microsysdeve/fjl_20191023/清单.pdf

品名 | 型号 | 数量 | 组件 | 备注
三相电压继电器 | XJ3-G | 1 | 总控制
空气开关 | NM1-3300-400A 三相 | 1 | 总控制
启动按钮绿 | 2常开2常闭红, | 1 总控制
停止按钮绿 | 2常开2常闭绿 | 1 | 总控制
启动按钮绿 | 2常开2常闭红, | 400A接触器控制
停止按钮绿 | 2常开2常闭绿 | | | 400A接触器控制
急停按钮（蘑菇头）4常开4常闭，带自锁 | | 2 | 总控制
三相电压表 | 42L6 500V | 1 | 总控制
三相电流表 | 42L6 400A | 1 | 总控制
互感器 | Bh-0.66 400/5 | 1 | 总控制
A相指示灯 | ND16-220V 红 | 1 | 总控制
C相指示灯 | ND16-220V 黄 | 1 | 总控制
B相指示灯 | ND16-220V 绿 | 1 | 总控制
接触器 | CJ20-400A 380V | 1 | 总控制
220-24V电源 150W | | 1
接触器 | CJX2-220V 0910 | 1 | 热风循环燃烧机控制
接触器 | CJX2-220V 3210 | 1 | 热风循环风机控制
空气开关 | DZ47-32A-3P D型 | 1 | 热风循环
空气开关 | DZ47-5A-3P | 1 | 热风循环
热继电器 | NR2-36/Z 23-32A | 1 | 热风循环
接线端子 | TD-20A/3P | 1 | 热风循环
接线端子 | TD-15A/7P | 1 | 热风循环
接触器 | CJX2-220V 0910 | 1 | 烘道热能水循环
空气开关 | DZ47-5A-2P | 1 | 烘道热能水循环
热继电器 | NR2-25/Z 5.5-8A | 1 | 烘道热能水循环
接线端子 | TD-15A/5P | 1 | 烘道热能水循环
接触器 | CJX2-220V 0910 | 1 | 热水炉
接触器 | CJX2-220V 1810 | 1 | 热水炉
空气开关 | DZ47-25A-3P D型 | 1 | 热水炉
空气开关 | DZ47-5A-2P | 1 | 热水炉
继电器 | JZX-24VF(D)/4Z-24V | 6 | 热水炉
热继电器 | NR2-25/Z 12-18A | 1 | 热水炉
接线端子 | TD-15A/22P | 1 | 热水炉
接触器 | CJX2-220V 1810 | 5 | 前处理
接触器 | CJX2-220V 2510 | 3 | 前处理
空气开关 | DZ47-10A-3P D型 | 5 | 前处理
空气开关 | DZ47-25A-3P D型 | 3 | 前处理
热继电器 | NR2-25/Z 9-13A | 5 | 前处理
热继电器 | NR2-25/Z 12-18A | 3 | 前处理
接线端子 | TD-20A 30P | 1
空气开关 | DZ47-16A-2P | 2 | 备用
空气开关 | DZ47-16A-3P | 2 | 备用
空气开关 | DZ47-40A-3P | 2 | 备用
空气开关 | DZ47-63A 3P | 2 | 备用
接线端子 | TD-10A/16P | 1 | | 2个单相16A空开+2个三相16A空开
接线端子 | TD-60A/12P | 1 | | 2个三相40A空开+2个三相60A空开
接线端子 | TD-15A/10P | 1
