microsysdeve/fjl_20191023/fjl_20191023供应清单.xlsx

Sheet: Sheet1
品名 | 型号 | 数量 | 组件 | 备注
三相电压继电器 | XJ3-G | 1 | 总控制
空气开关 | NM1-3300-400A 三相 | 1 | 总控制
启动按钮绿 | 2常开2常闭红, | 1 | 总控制
停止按钮绿 | 2常开2常闭绿 | 1 | 总控制
启动按钮绿 | 2常开2常闭红, | 1 | 总控制 | 400A接触器控制
停止按钮绿 | 2常开2常闭绿 | 1 | 总控制 | 400A接触器控制
急停按钮（蘑菇头） | 4常开4常闭，带自锁 | 2 | 总控制
互感器 | Bh-0.66 400/5 | 1 | 总控制
A相指示灯 | ND16-220V 红 | 1 | 总控制
C相指示灯 | ND16-220V 黄 | 1 | 总控制
B相指示灯 | ND16-220V 绿 | 1 | 总控制
接触器 | CJ20-400A 380V | 1 | 总控制
220-24V电源 200W |  | 1
空气开关 | NXB-5A 2P | 1 | 控制回路控制
接触器 | CJX2-220V 0910 | 1 | 热风循环燃烧机控制
接触器 | CJX2-220V 3210 | 1 | 热风循环风机控制
空气开关 | NXB-32A-3P D型 | 1 | 热风循环
空气开关 | NXB-5A-3P | 1 | 热风循环
热继电器 | NR2-36/Z 23-32A | 1 | 热风循环
接线端子 | TD-20A/3P | 1 | 热风循环
接线端子 | TD-15A/7P | 1 | 热风循环
接触器 | CJX2-220V 0910 | 1 | 烘道热能水循环
空气开关 | NXB-5A-2P | 1 | 烘道热能水循环
热继电器 | NR2-25/Z 5.5-8A | 1 | 烘道热能水循环
接线端子 | TD-15A/5P | 1 | 烘道热能水循环
接触器 | CJX2-220V 0910 | 1 | 热水炉
接触器 | CJX2-220V 1810 | 1 | 热水炉
空气开关 | NXB-25A-3P D型 | 1 | 热水炉
空气开关 | NXB-5A-2P | 1 | 热水炉
继电器 | JZX-24VF(D)/4Z-24V | 6 | 热水炉
热继电器 | NR2-25/Z 12-18A | 1 | 热水炉
接线端子 | TD-15A/22P | 1 | 热水炉
接触器 | CJX2-220V 1810 | 5 | 前处理
接触器 | CJX2-220V 2510 | 3 | 前处理
空气开关 | NXB-10A-3P D型 | 5 | 前处理
空气开关 | NXB-25A-3P D型 | 3 | 前处理
热继电器 | NR2-25/Z 9-13A | 5 | 前处理
热继电器 | NR2-25/Z 12-18A | 3 | 前处理
接线端子 | TD-20A 30P | 1
空气开关 | NXB-16A-2P | 5 | 备用
空气开关 | NXB-16A-3P | 2 | 备用
空气开关 | NXB-40A-3P | 2 | 备用
空气开关 | NXB-63A 3P | 2 | 备用
接线端子 | TD-10A/16P | 1 |  | 2个单相16A空开+2个三相16A空开
接线端子 | TD-60A/12P | 1 |  | 2个三相40A空开+2个三相60A空开
接线端子 | TD-15A/10P | 1
接触器 | CJX2-220V 0910 | 1 | 粉尘控制 | 喷房电源1
接触器 | CJX2-220V 0910 | 1 | 粉尘控制 | 喷房电源2
继电器 | JZX-24VF(D)/4Z-24V | 6 | 粉尘控制
按钮 |  | 6 | 粉尘控制 | 二常开二常闭
24V指示灯 | 红色 | 1 | 粉尘控制
选择开关 |  | 1 | 粉尘控制 | 二常开二常闭

Sheet: 联动控制器购买清单
编号 | 器件名称 | 规格 | 功能
SB1 | 按钮 | LAY2，不自锁,1常开1常闭 | 启动
SB2 | 按钮 | LAY2，不自锁,1常开1常闭 | 停止
SB3 | 按钮 | LAY2，不自锁,2常开 | 复位
N1 | 拨动开关 | 2常开 | 联动/手动
N2 | 拨动开关 | 2常开， | 正转/反转
L1 | 指示灯 | ND16，24V，绿 | 运行指示灯
L2 | 指示灯 | ND16，24V ,黄 | 报警指示灯
L3 | 指示灯 | ND16，220V，红 | 电源指示灯
L4 | 指示灯 | ND16，24V，白 | 外部即停指示灯
L5 | 指示灯 | ND16，24V，红 | 主动限位指示灯
L6 | 指示灯 | ND16，24V，红 | 从动限位指示灯
J1 | 继电器 | 24V，4常开4常闭 | 变频器启动
J2 | 继电器 | 24V，4常开4常闭 | 联动/手动控制
J3 | 继电器 | 24V，4常开4常闭 | 反转/正转控制
j4 | 继电器 | 24V，4常开4常闭 | 报警控制
J5 | 继电器 | 24V，4常开4常闭 | 外部急停
j6 | 继电器 | 24V，4常开4常闭 | 主动限位
j7 | 继电器 | 24V，4常开4常闭 | 从动限位
j8 | 继电器 | 24V，4常开4常闭 | 启动
S | 接线端子 | TD1520 | 15A ,25节
W1 | 主动电位器 | 碳膜，10K
W2 | 从动电位器 | 碳膜，10K
D1 | 空气开关 | NXB C10 3P
D2 | 空气开关 | NXB C10 3P
