microsysdeve/fjl_20191023/fjl_20191023.xlsx

Sheet: Sheet1
品名 | 型号 | 数量 | 组件 | 备注 | 编 号 | 备注 | 单价
三相电压继电器 | XJ3-G | 1 | 总控制 |  | D1 |  | 33
空气开关 | NM1-3300-400A 三相 | 1 | 总控制 |  | QFZ |  | 454.3
启动按钮绿 | 2常开2常闭红, | 1 | 总控制 |  | SB1 |  | 12
停止按钮绿 | 2常开2常闭绿 | 1 | 总控制 |  | SB2 |  | 12
启动按钮绿 | 2常开2常闭红, |  |  | 400A接触器控制
停止按钮绿 | 2常开2常闭绿 |  |  | 400A接触器控制
急停按钮（蘑菇头） | 4常开4常闭，带自锁 | 2 | 总控制 |  | SB3 |  | 14
三相电压表 | 42L6 500V | 1 | 总控制 |  | M1 |  | 27
三相电流表 | 42L6 400A | 1 | 总控制 |  | M2 |  | 27
互感器 | Bh-0.66 400/5 | 1 | 总控制 |  | BH1 |  | 21
A相指示灯 | ND16-220V 红 | 1 | 总控制 |  | LQ1 |  | 4.5
C相指示灯 | ND16-220V 黄 | 1 | 总控制 |  | LQ3 |  | 4.5
B相指示灯 | ND16-220V 绿 | 1 | 总控制 |  | LQ2 |  | 4.5
接触器 | CJ20-400A 380V | 1 | 总控制 |  | KMZ
220-24V电源 200W |  | 1
空气开关 | NXB-5A 2P | 1 | 控制回路控制 |  | QFY
接触器 | CJX2-220V 0910 | 1 | 热风循环燃烧机控制 |  | KMA3 |  | 29.5
接触器 | CJX2-220V 3210 | 1 | 热风循环风机控制 |  | KMA2 |  | 80
空气开关 | NXB-32A-3P D型 | 1 | 热风循环 |  | QFA2 |  | 20
空气开关 | NXB-5A-3P | 1 | 热风循环 |  | QFA3 |  | 22
热继电器 | NR2-36/Z 23-32A | 1 | 热风循环 |  | FR02 |  | 67
接线端子 | TD-20A/3P | 1 | 热风循环
接线端子 | TD-15A/7P | 1 | 热风循环
接触器 | CJX2-220V 0910 | 1 | 烘道热能水循环 |  | KMB1 |  | 29.5
空气开关 | NXB-5A-2P | 1 | 烘道热能水循环 |  | QFB1 |  | 22
热继电器 | NR2-25/Z 5.5-8A | 1 | 烘道热能水循环 |  | FRB1 |  | 67
接线端子 | TD-15A/5P | 1 | 烘道热能水循环
接触器 | CJX2-220V 0910 | 1 | 热水炉 |  | KME2 |  | 29.5
接触器 | CJX2-220V 1810 | 1 | 热水炉 |  | KME1 |  | 45
空气开关 | NXB-25A-3P D型 | 1 | 热水炉 |  | QFE1 |  | 20
空气开关 | NXB-5A-2P | 1 | 热水炉 |  | QFE2 |  | 22
继电器 | JZX-24VF(D)/4Z-24V | 6 | 热水炉 |  | JE1-JE8 |  | 13
热继电器 | NR2-25/Z 12-18A | 1 | 热水炉 |  | FRE1 |  | 29
接线端子 | TD-15A/22P | 1 | 热水炉
接触器 | CJX2-220V 1810 | 5 | 前处理 |  | KM11，KM12，KM13，KM15，KM16，KM17 |  | 29.5
接触器 | CJX2-220V 2510 | 3 | 前处理 |  | KM10 |  | 45
空气开关 | NXB-10A-3P D型 | 5 | 前处理 |  | QF14，QF15，QF16，QF18，QF19，QF20 |  | 20
空气开关 | NXB-25A-3P D型 | 3 | 前处理 |  | QF13 |  | 20
热继电器 | NR2-25/Z 9-13A | 5 | 前处理 |  | JR9,JR10,JR11，JR13,JR14,JR15 |  | 29
热继电器 | NR2-25/Z 12-18A | 3 | 前处理 |  | JR8 |  | 29
接线端子 | TD-20A 30P | 1
空气开关 | NXB-16A-2P | 5 | 备用 |  | QF50-QF54 |  | 13.5
空气开关 | NXB-16A-3P | 2 | 备用 |  | QF60-QF61 |  | 20
空气开关 | NXB-40A-3P | 2 | 备用 |  | QF65-QF66 |  | 23
空气开关 | NXB-63A 3P | 2 | 备用 |  | QF67-QF68 |  | 25
接线端子 | TD-10A/16P | 1 |  | 2个单相16A空开+2个三相16A空开 |  | 5个单相16A空开+2个三相16A空开 | 12
接线端子 | TD-60A/12P | 1 |  | 2个三相40A空开+2个三相60A空开 |  | 2个三相40A空开+2个三相60A空开 | 4
接线端子 | TD-15A/10P | 1 |  |  |  |  | 12
接触器 | CJX2-220V 0910 | 1 | 粉尘控制 | 喷房电源1
接触器 | CJX2-220V 0910 | 1 | 粉尘控制 | 喷房电源2
继电器 | JZX-24VF(D)/4Z-24V | 6 | 粉尘控制 |  |  |  | 13
按钮 |  | 6 | 粉尘控制 | 二常开二常闭
24V指示灯 | 红色 | 1 | 粉尘控制
选择开关 |  | 1 | 粉尘控制 | 二常开二常闭

Sheet: Sheet2
2常开2常闭红 汇总 | #REF!
2常开2常闭绿 | 1
2常开2常闭绿 汇总 | 1
2常开2常闭红 | 1
2常开2常闭红 汇总 | 1
2常开2常闭绿 | 1
2常开2常闭绿 汇总 | 1
2常开2常闭，带自锁 | 2
2常开2常闭，带自锁 汇总 | 2
42L6 500V | 1
42L6 500V 汇总 | 1
42L6 300A | 1
42L6 300A 汇总 | 1
Bh-0.66 300/5 | 1
Bh-0.66 300/5 汇总 | 1
CJ20-400A 380V 三相 | 1
CJ20-400A 380V 三相 汇总 | 1
CJX2-220V 0910 | 1
CJX2-220V 0910 | 1
CJX2-220V 0910 | 1
CJX2-220V 0910 | 5
CJX2-220V 0910 | 1
CJX2-220V 0910 | 3
CJX2-220V 0910 汇总 | 12
CJX2-220V 1810 | 1
CJX2-220V 1810 | 1
CJX2-220V 1810 | 4
CJX2-220V 1810 | 1
CJX2-220V 1810 | 1
CJX2-220V 1810 | 1
CJX2-220V 1810 | 1
CJX2-220V 1810 | 3
CJX2-220V 1810 汇总 | 13
CJX2-220V 3210 | 1
CJX2-220V 3210 汇总 | 1
CJX2-220V 4011 | 1
CJX2-220V 4011 | 1
CJX2-220V 4011 汇总 | 2
CJX2-220V 5010 | 1
CJX2-220V 5010 汇总 | 1
DZ47-10A-3P | 5
DZ47-10A-3P | 3
DZ47-10A-3P 汇总 | 8
DZ47-15A-3P | 1
DZ47-15A-3P | 1
DZ47-15A-3P 汇总 | 2
DZ47-16A 2P | 10
DZ47-16A 2P 汇总 | 10
DZ47-16A 3P | 5
DZ47-16A 3P 汇总 | 5
DZ47-16A-3P | 1
DZ47-16A-3P 汇总 | 1
DZ47-25A-3P | 1
DZ47-25A-3P | 4
DZ47-25A-3P 汇总 | 5
DZ47-32A-3P | 1
DZ47-32A-3P | 1
DZ47-32A-3P | 1
DZ47-32A-3P 汇总 | 3
DZ47-3A-3P | 1
DZ47-3A-3P 汇总 | 1
DZ47-40A-2P | 1
DZ47-40A-2P 汇总 | 1
DZ47-40A-3P | 2
DZ47-40A-3P | 1
DZ47-40A-3P 汇总 | 3
DZ47-5A-3P | 1
DZ47-5A-3P | 1
DZ47-5A-3P | 1
DZ47-5A-3P | 3
DZ47-5A-3P 汇总 | 6
DZ47-60 3P C40A | 1
DZ47-60 3P C40A 汇总 | 1
DZ47-63A 3P | 2
DZ47-63A 3P 汇总 | 2
JZX-22F(D)/4Z-220V | 6
JZX-22F(D)/4Z-220V | 1
JZX-22F(D)/4Z-220V 汇总 | 7
JZX-22F(D)/4Z-24V | 2
JZX-22F(D)/4Z-24V 汇总 | 2
ND16-220V 红 | 1
ND16-220V 红 汇总 | 1
ND16-220V 黄 | 1
ND16-220V 黄 汇总 | 1
ND16-220V 绿 | 1
ND16-220V 绿 汇总 | 1
NM1-3300-400A 三相 | 1
NM1-3300-400A 三相 汇总 | 1
NR2-93/Z23-32A | 1
NR2-93/Z23-32A | 1
NR2-93/Z23-32A | 1
NR2-93/Z23-32A | 1
NR2-93/Z23-32A | 9
NR2-93/Z23-32A | 1
NR2-93/Z23-32A | 3
NR2-93/Z23-32A | 3
NR2-93/Z23-32A | 1
NR2-93/Z23-32A | 1
NR2-93/Z23-32A 汇总 | 22
NR2-93/Z37-50A | 1
NR2-93/Z37-50A | 1
NR2-93/Z37-50A 汇总 | 2

Sheet: 面板安排
A相电源指示灯 | 总控
B相电源指示灯 | 总控
C相电源指示灯 | 总控
系统启动按钮 | 总控
系统停止按钮 | 总控
急停按钮（蘑菇头） | 总控
三相电压表 | 总控
三相电流表 | 总控
触摸屏 | 总控
声光报警指示灯 | 总控
金工热能表 | 热风循环
调速电位器 | 悬挂链
转速表 | 悬挂链
链条启动 | 悬挂链
链条停止 | 悬挂链
链条运行指示灯 | 悬挂链
链条外部即停指示灯 | 悬挂链
启动 | 防尘 | 杨志甫部分
停止 | 防尘
霍宇温控表1 | 热水炉
霍宇温控表2 | 热水炉
霍宇温控表3 | 热水炉

Sheet: io
1 | 系统启动 | 1 | 热风循环风机输出
2 | 系统急停 | 2 | 热风循环燃烧机输出
3 | 热风循环电机保护 | 3 | 烘道热能水循环使能输出
4 | 烘道热能水循环电机保护 | 4 | 热水炉水泵输出
5 | 烘道废汽水泵热保护 | 5 | 热水炉燃烧机输出
6 | 悬持链电机保护 | 6 | 前处理-主脱脂输出
7 | 热水炉水泵热保护 | 7 | 前处理-主脂脱浸输出
8 | 热水炉命令状态 | 8 | 前处理-水洗1输出
9 | 前处理-主脱脂热保护 | 9 | 前处理-水洗3输出出
10 | 前处理-主脂脱浸热保护 | 10 | 前处理-预脱脂输出
11 | 前处理-水洗浸热保护 | 11 | 前处理-水洗2输出
12 | 前处理-排风风机热保护 | 12 | 前处理-水洗4输出
13 | 前处理-预脱脂热保护 | 13 | 前处理-热水洗输出
14 | 前处理-水洗热保护
15 | 前处理-硅烷热保护
16 | 前处理-纯水1热保护
1 | x外部急停 | 1 | Y除尘卸灰输出A | oqc
2 | x系统启动 | 2 | Y除尘卸灰输出B
3 | x系统停止 | 3 | y报警输出
4 | x_EX7 | 4 | Y通道选择
5 | x_EX8 | 5 | Y排风机输出
6 | x喷房通道选择 | 6 | Y锁气卸灰输出A1
7 | x防火阀输入 | 7 | Y锁气卸灰输出B1
8 | x火焰探测1报警 | 8 | y火焰探测电源输出
9 | x火焰探测2报警x | 9 | Y喷房电源1输出
10 | x火焰探测3报警x | 10 | Y喷房清扫1输出
11 | x火焰探测4报警x | 11 | Y喷淋1输出
12 | x喷房1启动 | 12 | Y锁气卸灰输出A2
13 | x喷房1停止 | 13 | Y锁气卸灰输出B2
14 | x喷房2启动 | 14 | Y喷房电源2输出
15 | x喷房2停止 | 15 | Y喷房清扫2输出
16 | 料位检测 | 16 | Y喷淋2输出
17 | r除尘锁汽卸灰检测使能 | 17 | y脉冲仪G
18 |  | 18 | Y除尘喷淋
19 |  | 19 | 备用2
 |  | 20 | 备用3

Sheet: 内部操作面板
温控表 | 烘道热能水循环
手动/自动开关 | 悬挂链
正/反转开关 | 悬挂链
主动限位开关指示灯 | 悬挂链
从动限位开关指示灯 | 悬挂链
调速电位器 | 悬挂链

Sheet: 联动控制器
编号 | 器件名称 | 规格 | 功能
SB1 | 按钮 | LAY2，不自锁,1常开1常闭 | 启动
SB2 | 按钮 | LAY2，不自锁,1常开1常闭 | 停止
SB3 | 按钮 | LAY2，不自锁,2常开 | 复位
N1 | 拨动开关 | 2常开 | 联动/手动
N2 | 拨动开关 | 2常开， | 正转/反转
L1 | 指示灯 | ND16，24V，绿 | 运行指示灯
L2 | 指示灯 | ND16，24V ,黄 | 报警指示灯
L3 | 指示灯 | ND16，220V，红 | 电源指示灯
L4 | 指示灯 | ND16，24V，白 | 外部即停指示灯
L5 | 指示灯 | ND16，24V，红 | 主动限位指示灯
L6 | 指示灯 | ND16，24V，红 | 从动限位指示灯
J1 | 继电器 | 24V，4常开4常闭 | 变频器启动
J2 | 继电器 | 24V，4常开4常闭 | 联动/手动控制
J3 | 继电器 | 24V，4常开4常闭 | 反转/正转控制
j4 | 继电器 | 24V，4常开4常闭 | 报警控制
J5 | 继电器 | 24V，4常开4常闭 | 外部急停
j6 | 继电器 | 24V，4常开4常闭 | 主动限位
j7 | 继电器 | 24V，4常开4常闭 | 从动限位
j8 | 继电器 | 24V，4常开4常闭 | 启动
Z1 | 主动变频器
Z2 | 从动变频器
X | 24V电源 | 220V 24V 50W
S | 接线端子 | TD1520 | 15A ,25节
W1 | 主动电位器 | 碳膜，10K
W2 | 从动电位器 | 碳膜，10K
W3 | 拉绳电位器
T1 | 主动限位开关 | 常闭 | 常闭
T2 | 从动限位开关 | 常闭 | 常闭
Y | 速度表
 | 按钮标字框
 | 电箱
D1 | 空气开关 | NXB C10 3P
D2 | 空气开关 | NXB C10 3P

Sheet: 联动控制器购买清单
编号 | 器件名称 | 规格 | 功能
SB1 | 按钮 | LAY2，不自锁,1常开1常闭 | 启动
SB2 | 按钮 | LAY2，不自锁,1常开1常闭 | 停止
SB3 | 按钮 | LAY2，不自锁,2常开 | 复位
N1 | 拨动开关 | 2常开 | 联动/手动
N2 | 拨动开关 | 2常开， | 正转/反转
L1 | 指示灯 | ND16，24V，绿 | 运行指示灯
L2 | 指示灯 | ND16，24V ,黄 | 报警指示灯
L3 | 指示灯 | ND16，220V，红 | 电源指示灯
L4 | 指示灯 | ND16，24V，白 | 外部即停指示灯
L5 | 指示灯 | ND16，24V，红 | 主动限位指示灯
L6 | 指示灯 | ND16，24V，红 | 从动限位指示灯
J1 | 继电器 | 24V，4常开4常闭 | 变频器启动
J2 | 继电器 | 24V，4常开4常闭 | 联动/手动控制
J3 | 继电器 | 24V，4常开4常闭 | 反转/正转控制
j4 | 继电器 | 24V，4常开4常闭 | 报警控制
J5 | 继电器 | 24V，4常开4常闭 | 外部急停
j6 | 继电器 | 24V，4常开4常闭 | 主动限位
j7 | 继电器 | 24V，4常开4常闭 | 从动限位
j8 | 继电器 | 24V，4常开4常闭 | 启动
S | 接线端子 | TD1520 | 15A ,25节
W1 | 主动电位器 | 碳膜，10K
W2 | 从动电位器 | 碳膜，10K
D1 | 空气开关 | NXB C10 3P
D2 | 空气开关 | NXB C10 3P
