microsysdeve/fjl_20191023/(list of files, cad)

Other CAD files:
粉尘控制.dwg
喷粉线控制柜面板.dwg
