microsysdeve/fjl_20191023/fjl_20191023.pdf

## 张家港市铭精峰机械有限公司 自动喷粉线电气控制原理 （热风循环） 7.5kw 风机启动 然后才能启动（燃烧机 三相电 1.5kw）（金工热能表控制） 燃烧机关机后风机进入 延时 0-30 分钟（可调） 后自动关闭

## 烘道热能水循环 启动后由一台（百特工控）温控表（无需安装在面板上，放在控制柜内部），设 定高报警，超出设定温度后启动 1.5kw 水泵循环，低于设定温度，水泵自动停

止工作.

## 悬挂链 由两台 三菱 E740-3.7KW 变频器 同步运行，外接电位器，外接 0-10v 转速 表（可校准），外接急停，复位后方可自动运行（不需要写入 PLC，安装面板按

钮）

## 热水炉 燃烧机 0.75kw 两相电（由霍宇温控表单独控制启停） 水泵 4kw 三相电 关 联三台 24v 电动执行器，执行器由霍宇温控表控制开与关，当三台执行器全部 关闭状态，水泵自动停止，如任意一台执行器自动打开，水泵自动重启

## 前处理

预脱脂 5.5kw 水泵 | 主脱脂 5.5kw 水泵 | 水洗一 4kw 水泵 水洗二 4kw
硅烷 5.5kw 水泵 | 水洗三 4kw 水泵 | 水洗四 4kw 水泵 | 热水洗 4kw 水泵

## 此柜加入防爆除尘控制系统，一并写入 PLC 控制程序（该控制原理与杨志甫沟通）

## 备用电源 不需写入 PLC

两相电源空开 2P 16A | 5 个
三相 16A | 2 个
三相 40A | 2 个
三相 63A | 2 个

## 注意要求： 所有马达均为三相 380v 所有三相电机 需要热保护 总电源需要缺相保护 面板上有一个电流表，一个电压表 三个电源指示 一个总控制启动按钮，一个总控急停

### 金工热能 技术电话：张工 18962452610

进线

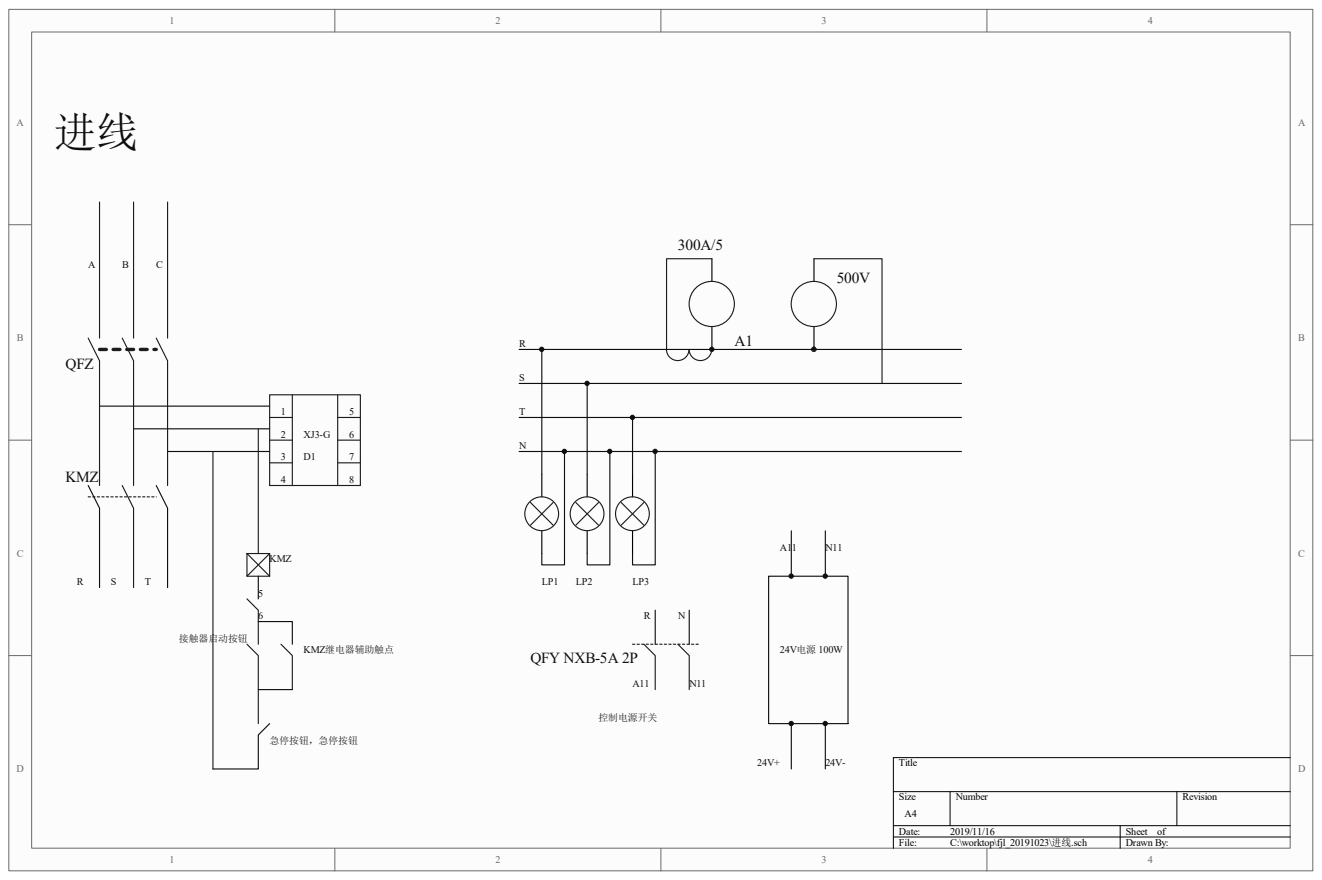
[picture p1: page 3]
Title; Size; Number; Revision; Date:; Sheet of; File:; C:\worktop\fjl_20191023\进线.sch; Drawn By:; KMZ; QFZ; 24V电源 100W; 急停按钮，急停按钮; KMZ继电器辅助触点; 接触器启动按钮; QFY NXB-5A 2P; 控制电源开关

## QFB1

RB11 | N | RB1

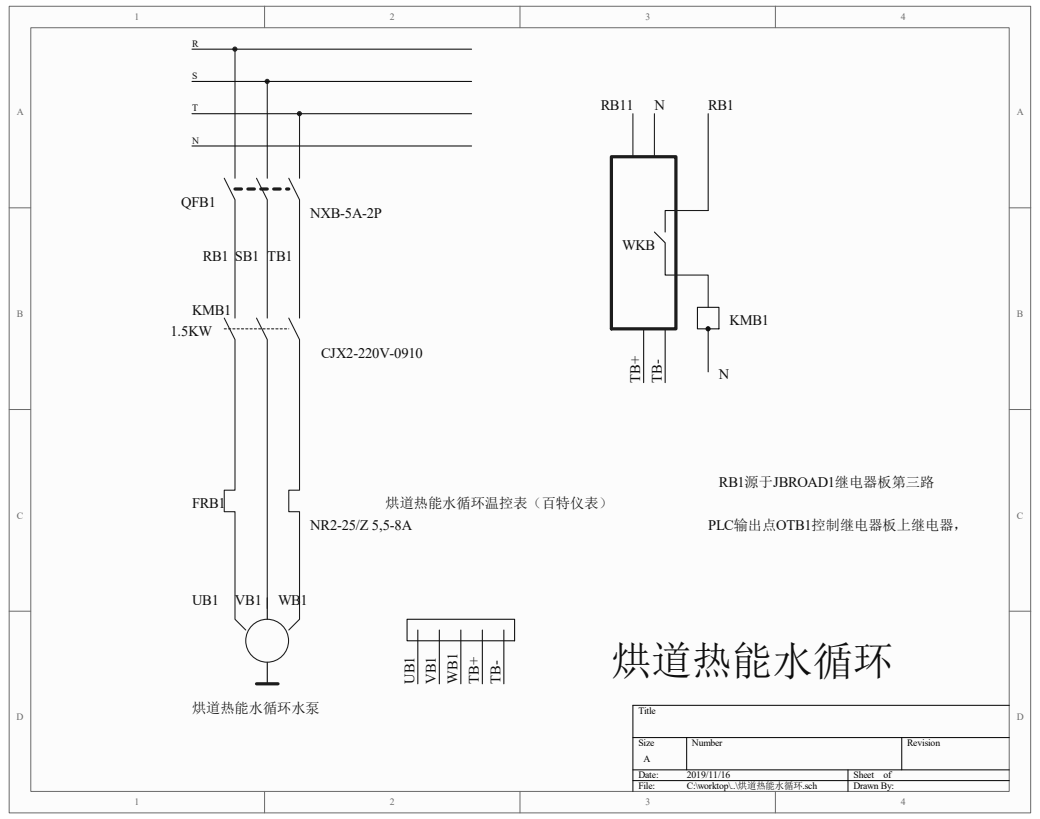
[picture p2: page 4]
Title; Size; Number; Revision; Date:; Sheet of; File:; C:\worktop\..\烘道热能水循环.sch; Drawn By:; KMB1; FRB1; UB¹; VB¹; WB¹; 烘道热能水循环水泵; 烘道热能水循环温控表（百特仪表）; WKB; PLC输出点OTB1控制继电器板上继电器，; 烘道热能水循环; RB1源于JBROAD1继电器板第三路; NXB-5A-2P; CJX2-220V-0910

# 热风循环

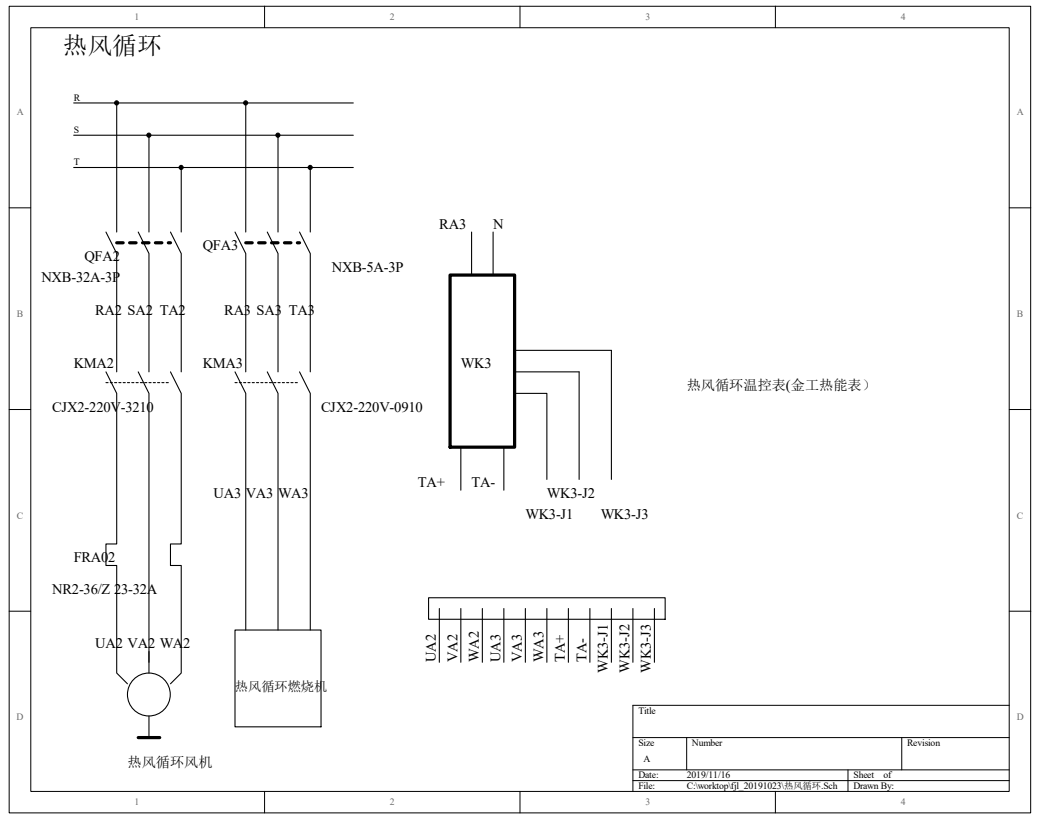
[picture p3: page 5]
Title; Size; Number; Revision; Date:; Sheet of; File:; C:\worktop\fjl_20191023\热风循环.Sch; Drawn By:; KMA2; QFA2; FRA02; KMA3; QFA3; 热风循环燃烧机; 热风循环风机; 热风循环温控表(金工热能表） UA²; VA²; WA²; UA³; VA³; WA³; TA⁻ WK³⁻J1 WK³⁻J2; WK3-J3WK³⁻J3; CJX2-220V-3210; CJX2-220V-0910; NXB-32A-3P; NXB-5A-3P

## 热水炉

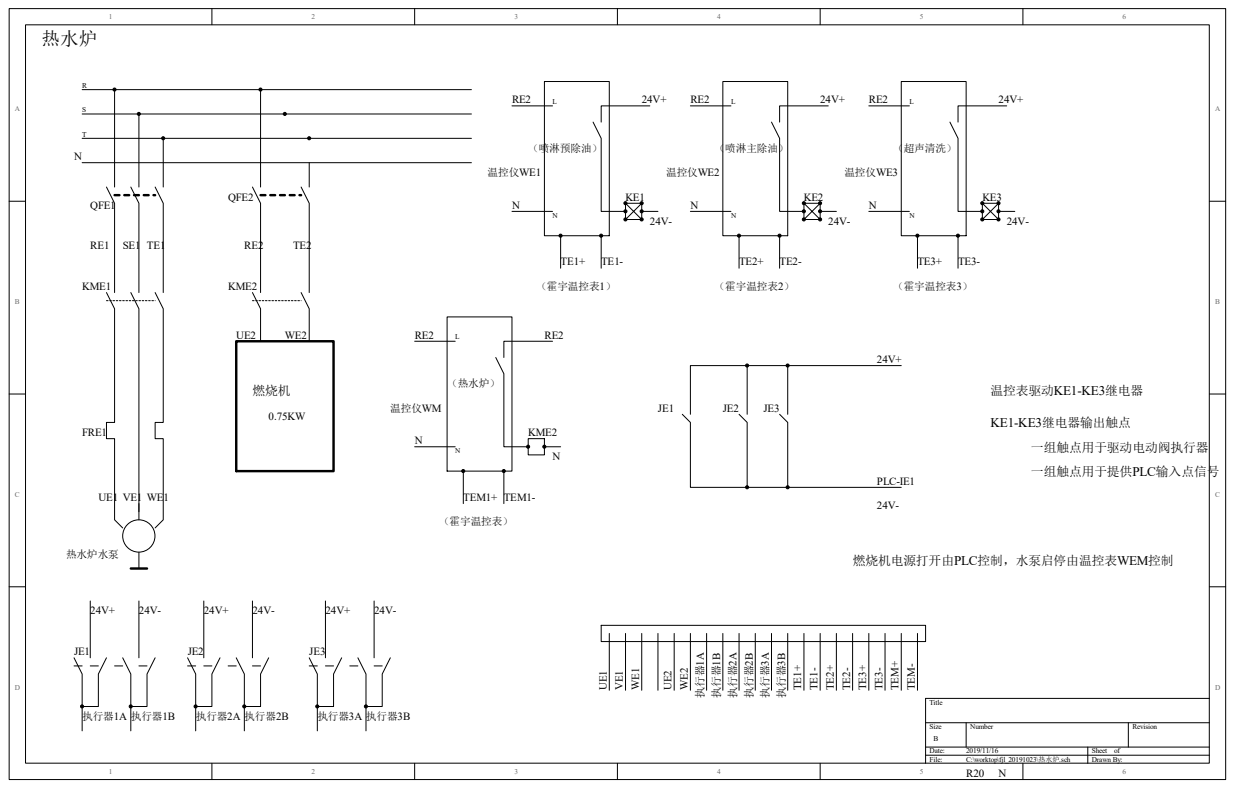
[picture p4: page 6]
Title; Size; Number; Revision; Date:; Sheet of; File:; C:\worktop\fjl_20191023\热水炉.sch; Drawn By:; KME1; QFE1; FRE1; KME2; QFE2; 热水炉水泵; 燃烧机; 温控仪WE2; PLC-IE1; JE1 UE¹; VE¹; WE¹; UE²; WE²; 执行器²B 执行器³A 执行器³B 执行器²A 执行器¹B 执行器¹A; （霍宇温控表2）; TE2-TE¹+; TE¹⁻; 温控仪WE3; （霍宇温控表3）; TE3- TE²+; TE²⁻; TE³+; TE³⁻; 温控仪WE1; （霍宇温控表1）; 执行器1A 执行器1B; 执行器2A 执行器2B; 执行器3A 执行器3B; 温控表驱动KE1-KE3继电器; KE1-KE3继电器输出触点; 一组触点用于驱动电动阀执行器; 一组触点用于提供PLC输入点信号; 温控仪WM; （霍宇温控表）; TEM1+; TEM1-; TEM⁺; TEM-; 燃烧机电源打开由PLC控制，水泵启停由温控表WEM控制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

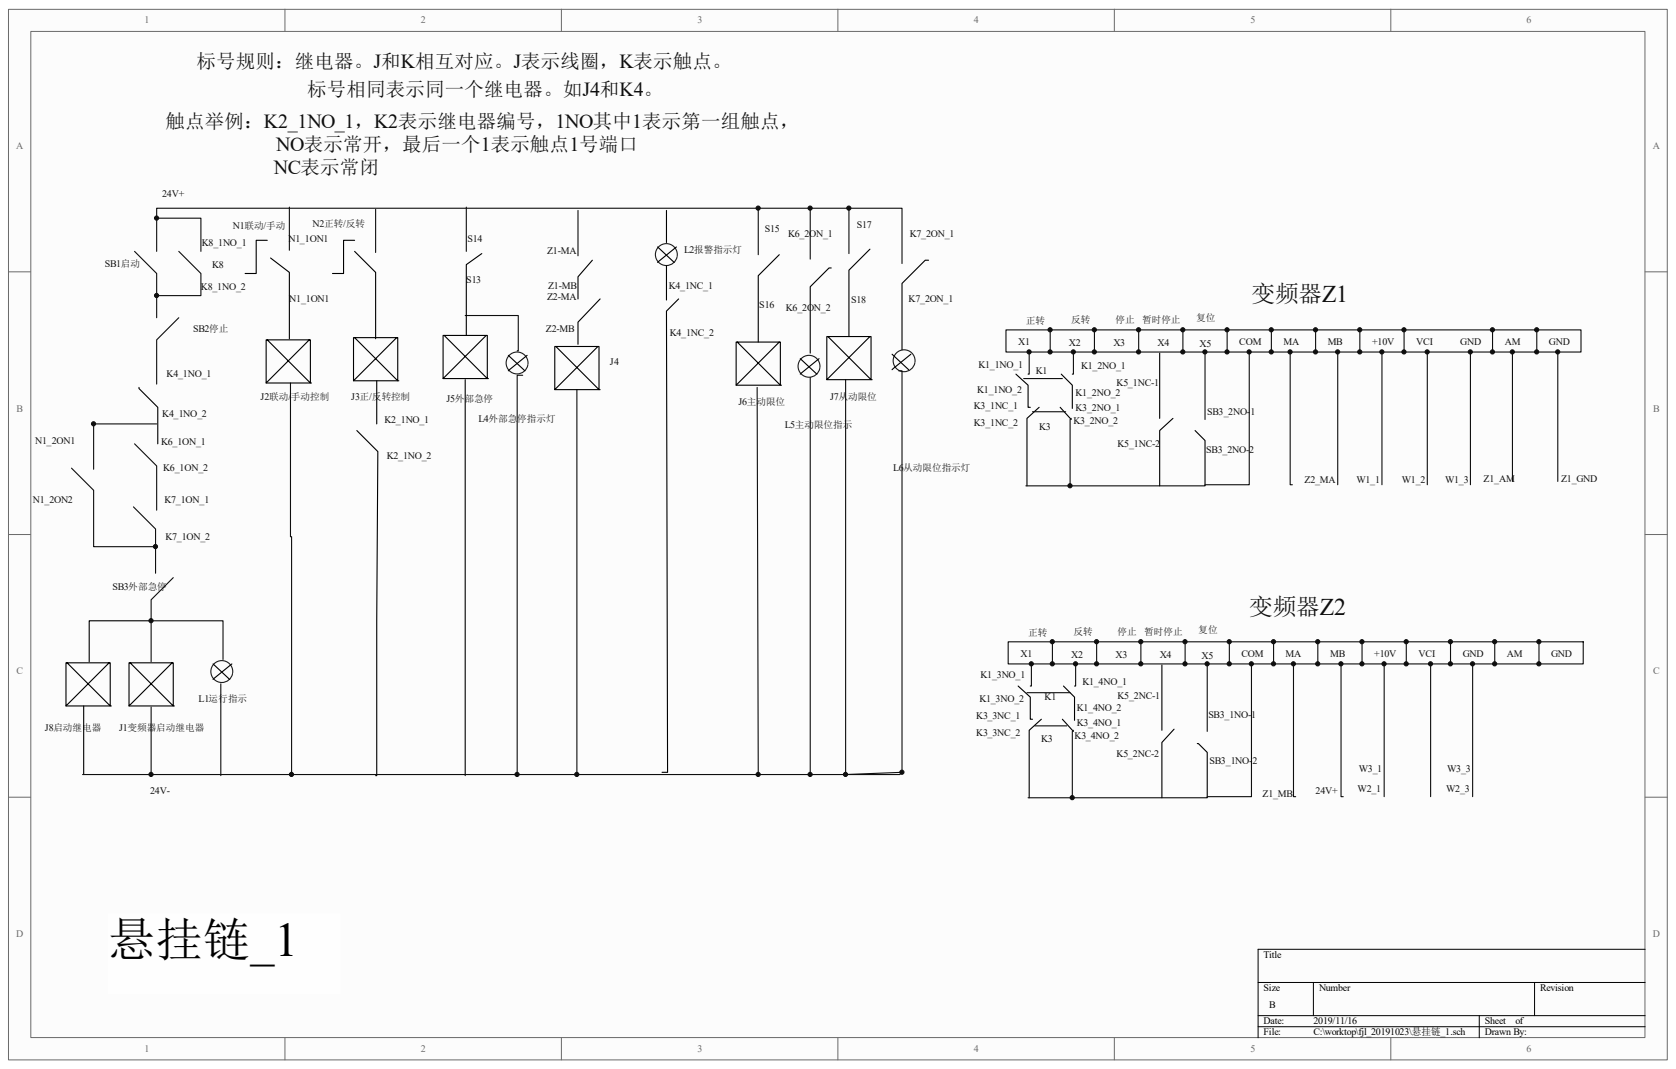
[picture p5: page 7]
Title; Size; Number; Revision; Date:; Sheet of; File:; C:\worktop\fjl_20191023\悬挂链_1.sch; Drawn By:; J1变频器启动继电器; L2报警指示灯; J2联动/手动控制; J3正/反转控制; L1运行指示; J5外部急停; SB3外部急停; L4外部急停指示灯; J6主动限位; J7从动限位; L5主动限位指示; L6从动限位指示灯; J8启动继电器; 标号相同表示同一个继电器。如J4和K4。; 触点举例：K2_1NO_1，K2表示继电器编号，1NO其中1表示第一组触点， NO表示常开，最后一个1表示触点1号端口 NC表示常闭; COM; VCI; GND; 停止 暂时停止; 变频器Z2; 变频器Z1; Z1_GND; 悬挂链_1

标号规则：继电器。J和K相互对应。J表示线圈，K表示触点。

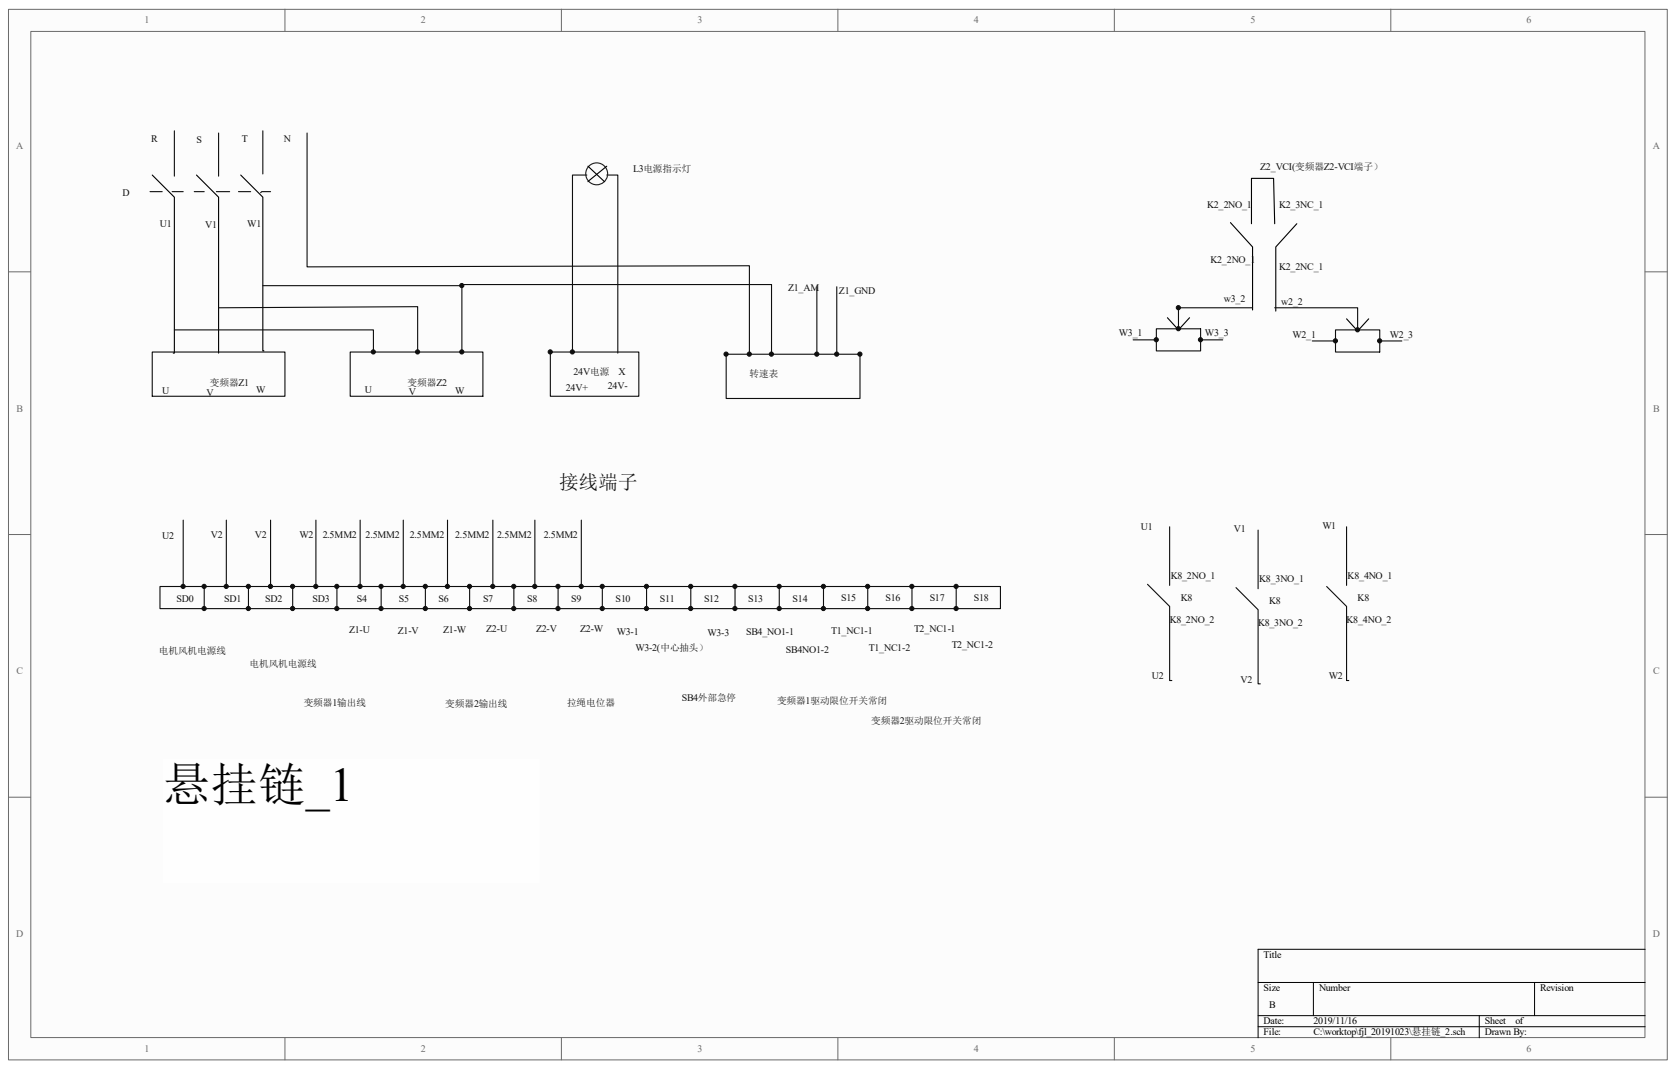
[picture p6: page 8]
Title; Size; Number; Revision; Date:; Sheet of; File:; C:\worktop\fjl_20191023\悬挂链_2.sch; Drawn By:; 变频器Z1; 变频器Z2; 24V电源 X; W3-2(中心抽头）; SB4外部急停; L3电源指示灯; 转速表; Z1_GND; 变频器1输出线; 变频器2输出线; 拉绳电位器; 变频器1驱动限位开关常闭; 变频器2驱动限位开关常闭; 接线端子; 电机风机电源线; Z2_VCI(变频器Z2-VCI端子）; 悬挂链_1

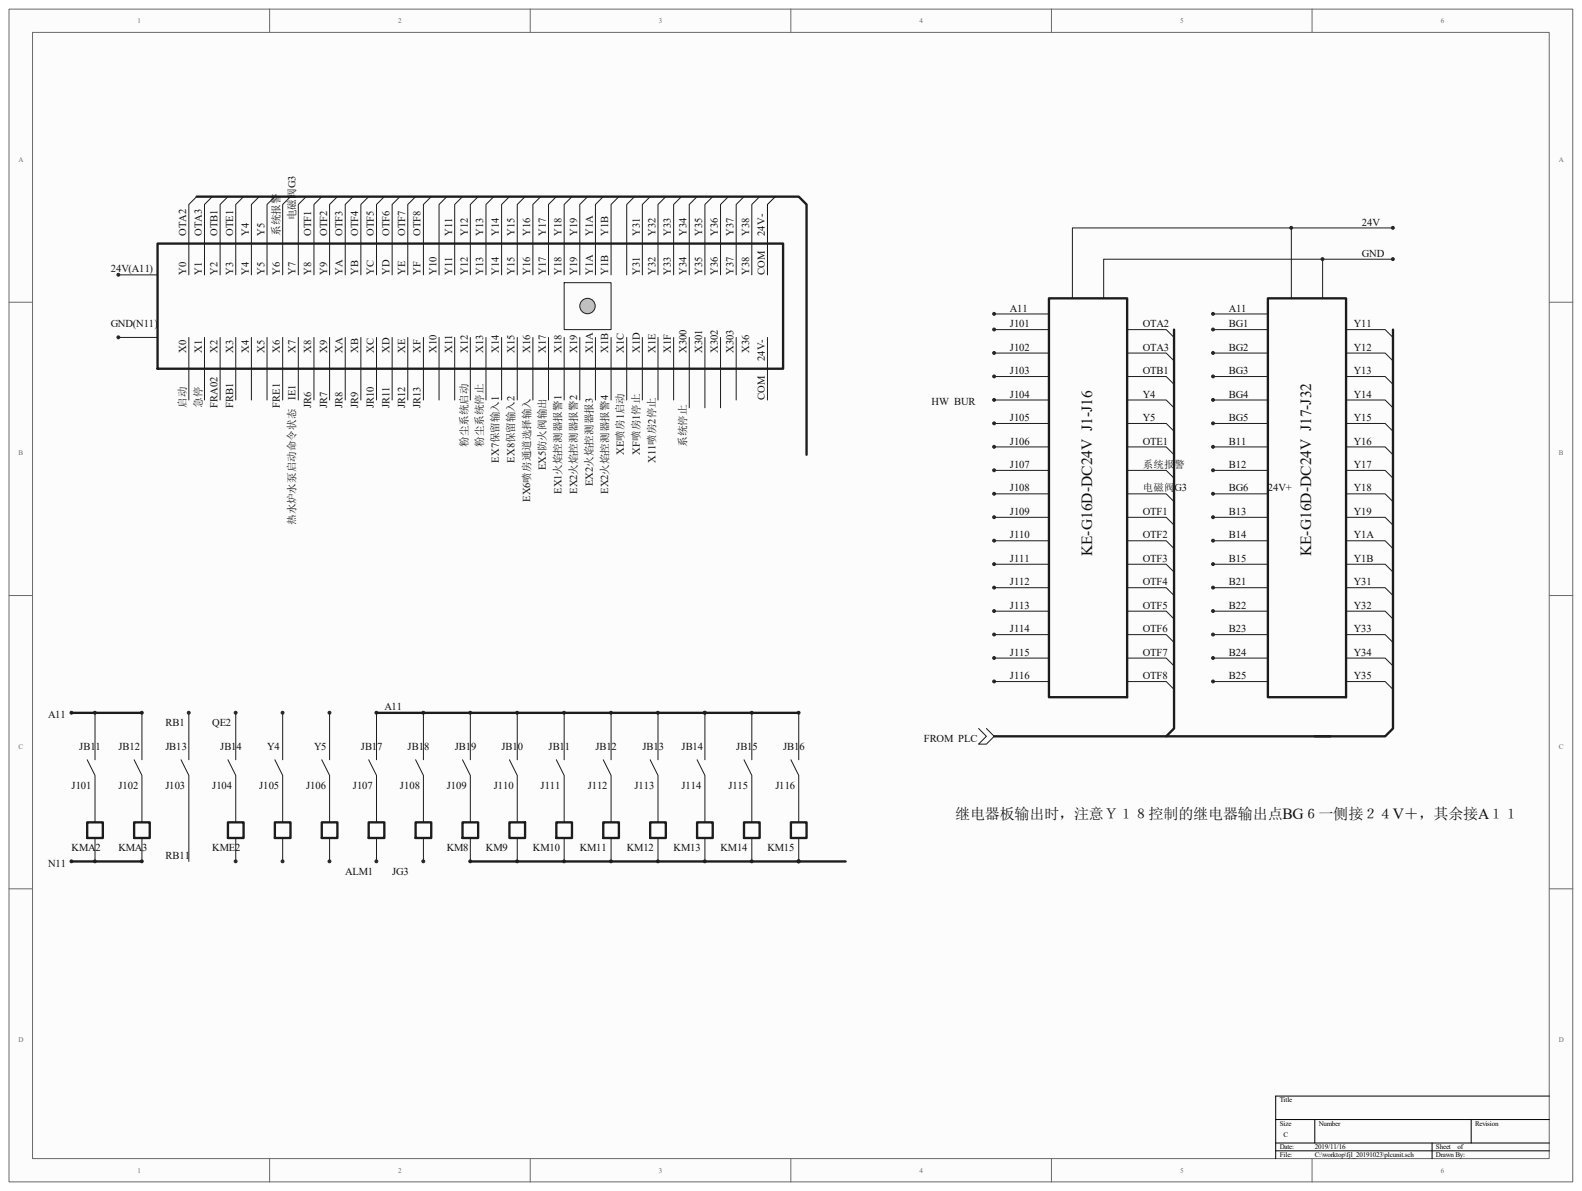
[picture p7: page 9]

# 前处理

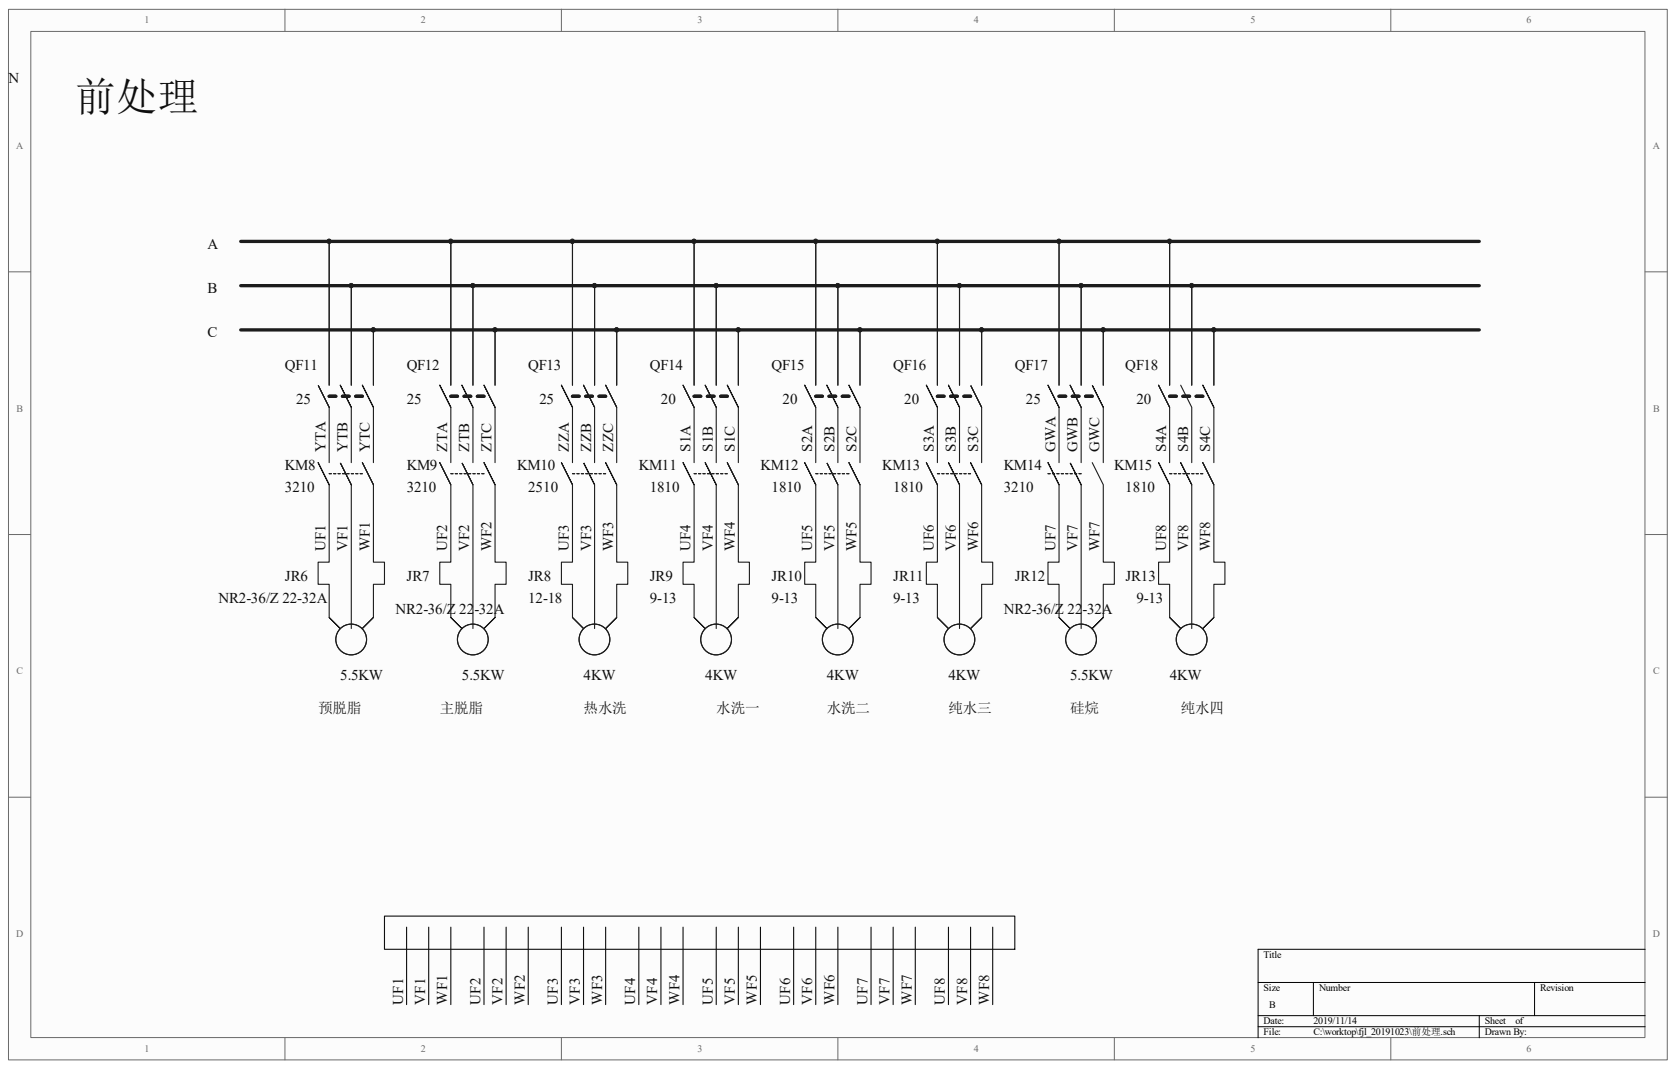
[picture p8: page 10]
Title; Size; Number; Revision; Date:; Sheet of; File:; C:\worktop\fjl_20191023\前处理.sch; Drawn By: UF¹; VF¹; WF¹; UF²; VF²; WF²; UF³; VF³; WF³; UF⁴; VF⁴; WF⁴; UF⁵; VF⁵; WF⁵; UF⁶; VF⁶; WF⁶; UF⁷; VF⁷; WF⁷; UF⁸; VF⁸; WF⁸; GWA; 预脱脂; 主脱脂; 热水洗; 水洗一; 水洗二; 纯水三; 纯水四 硅烷; 3210 GWB GWC; JR13 UF³ VF³ WF³; UF⁴ VF⁴ WF⁴; UF⁵ VF⁵ WF⁵; UF⁶ VF⁶ WF⁶; UF⁷ VF⁷ WF⁷; UF⁸ VF⁸ WF⁸

3210 YTA YTB YTC
5.5KW UF¹ VF¹ WF¹

3210 ZTA ZTB ZTC

2510 ZZA ZZB ZZC

1810 S¹A S¹B S¹C

1810 S²A S²B S²C

1810 S³A S³B S³C

1810 S⁴A S⁴B S⁴C

4KW UF² VF² WF²

备用

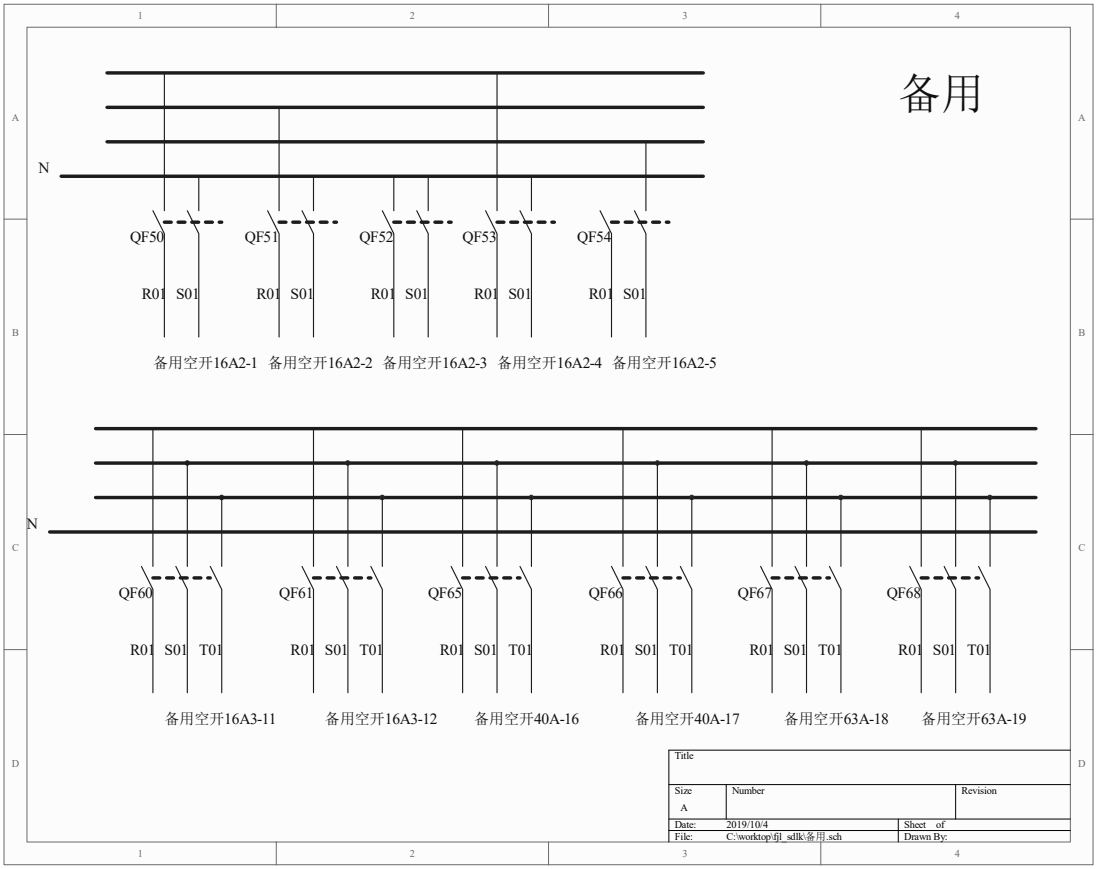
[picture p9: page 11]
Title; 备用空开16A2-1; 备用空开16A3-11; 备用空开16A3-12; 备用空开40A-16; 备用空开40A-17; 备用空开63A-18; 备用空开63A-19; 备用空开16A2-2 备用空开16A2-3 备用空开16A2-4 备用空开16A2-5

Size A | Number | Revision

Date: 2019/10/4 | Sheet of
File: C:\worktop\fjl_sdlk\备用.sch | Drawn By:

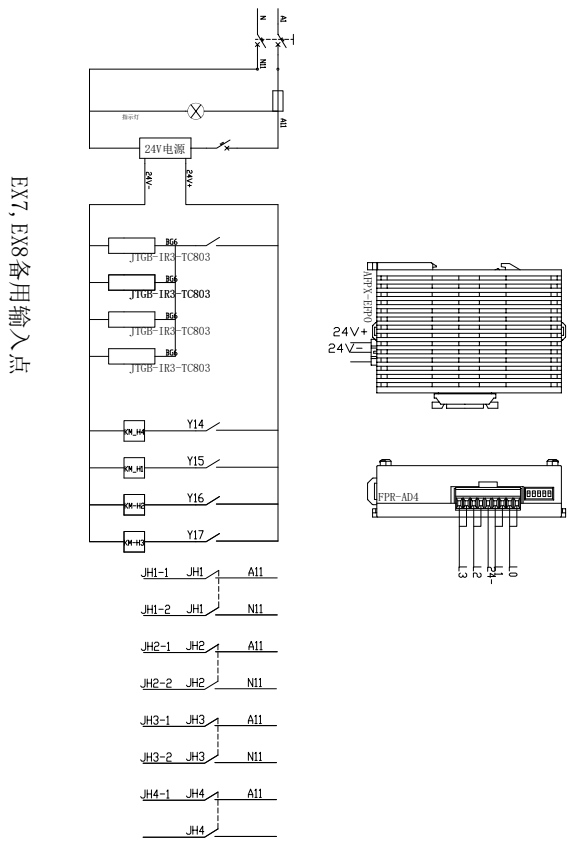
[picture p10: page 12]
24V电源; JTGB-IR3-TC803; 指示灯; FPR-AD4; AFPX-EFP0; EX7,EX8备用输入点

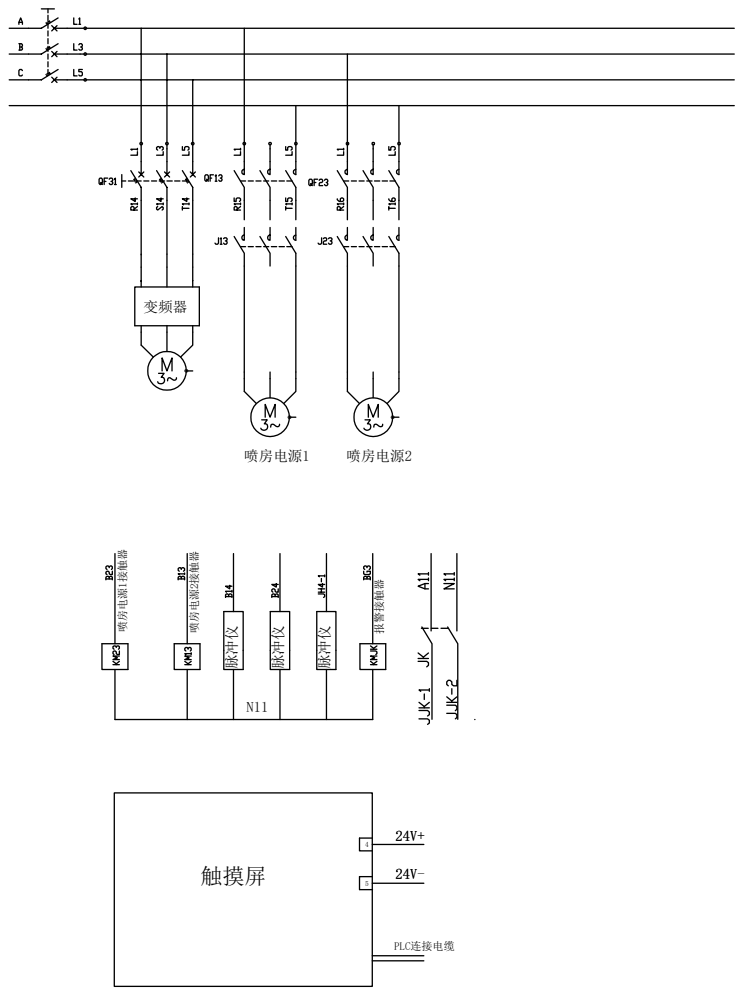
[picture p11: page 13]
变频器; 脉冲仪; 喷房电源1接触器; 喷房电源2接触器; 报警接触器; 喷房电源2; 5 触摸屏; PLC连接电缆; 喷房电源1

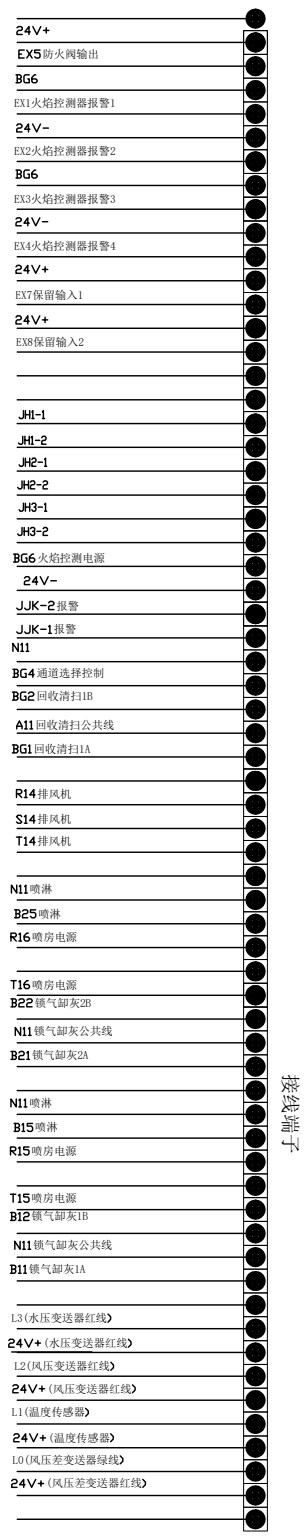
[picture p12: page 14]
接线端子; 防火阀输出; 喷房电源; 锁气缷灰1B; 排风机; 锁气缷灰公共线; 锁气缷灰1A; 火焰控测电源; L0(风压差变送器绿线; (风压差变送器红线; L1(温度传感器; (温度传感器; L2(风压变送器红线; (风压变送器红线; L3(水压变送器红线; (水压变送器红线; 锁气缷灰2B; 锁气缷灰2A; 回收清扫1B; 回收清扫公共线; 回收清扫1A; 通道选择控制; EX1火焰控测器报警1; EX2火焰控测器报警2; EX3火焰控测器报警3; EX4火焰控测器报警4; EX7保留输入1; EX8保留输入2

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
