microsysdeve/fjl_20191023/plcunit.pdf

24V

## GND

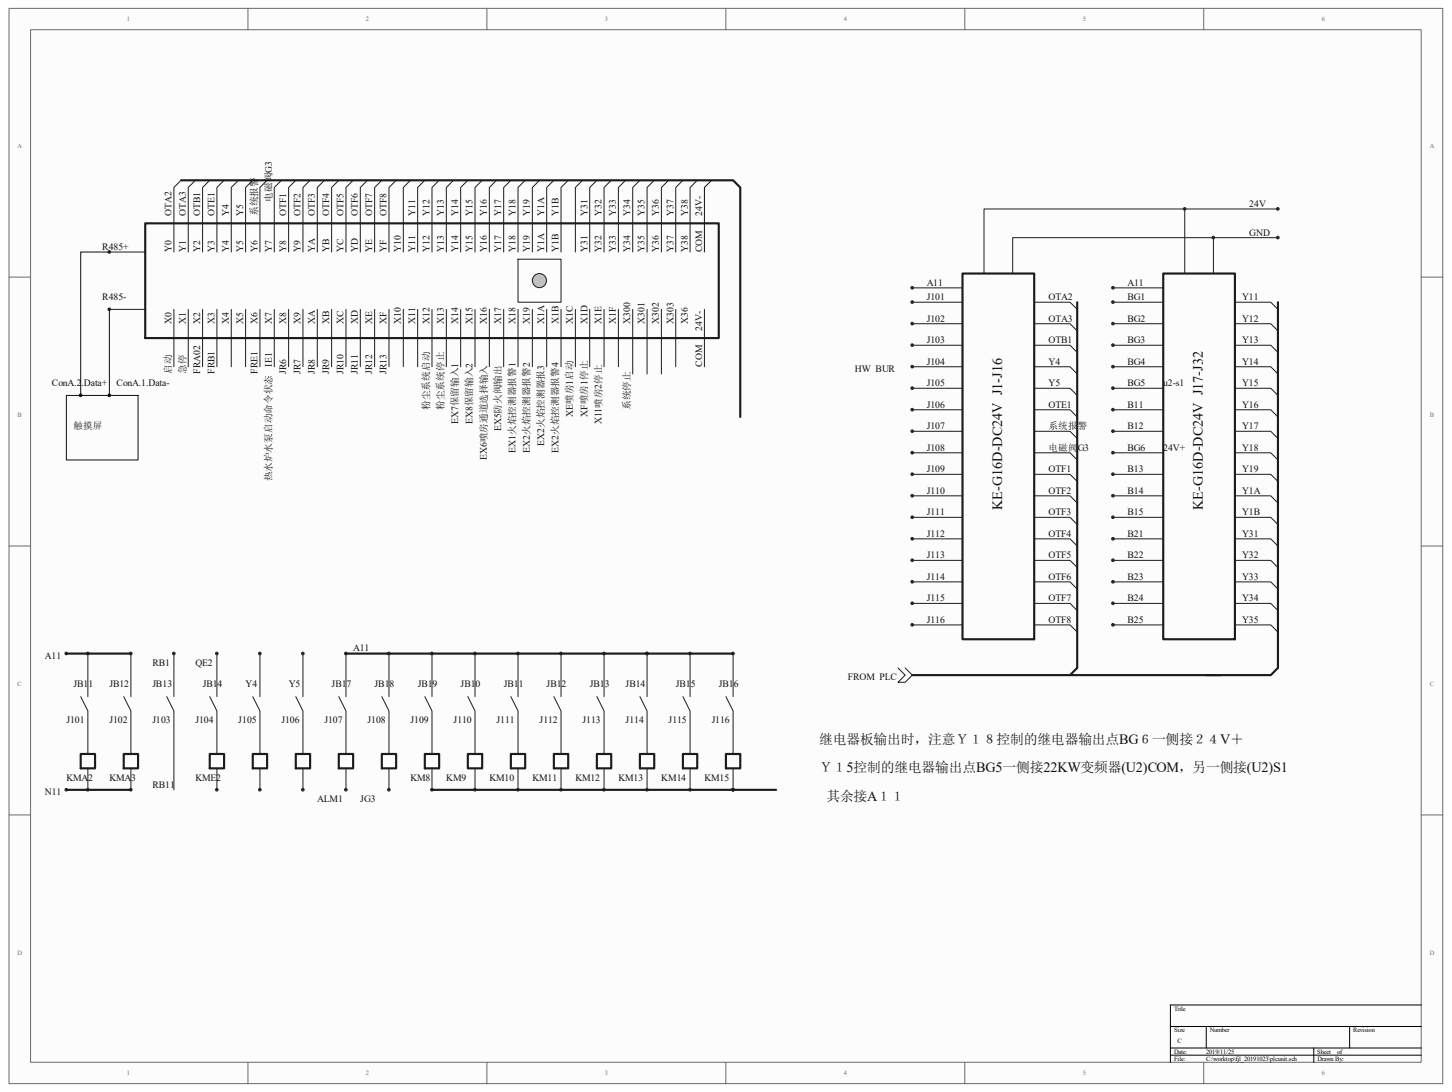
[picture p13: page 1]
