microsysdeve/fjl_20191023/烘道热能水循环.pdf

Title; Size; Number; Revision; Date:; Sheet of; File:; C:\worktop\..\烘道热能水循环.sch; Drawn By:; KMB1; QFB1; FRB1; UB¹; VB¹; WB¹; 烘道热能水循环水泵; 烘道热能水循环温控表（百特仪表）; WKB; PLC输出点OTB1控制继电器板上继电器，; 烘道热能水循环; RB1源于JBROAD1继电器板第三路; NXB-5A-2P; CJX2-220V-0910
