microsysdeve/fjl_20191023/悬挂链_1.pdf

# 标号相同表示同一个继电器。如J4和K4。

# 标号规则：继电器。J和K相互对应。J表示线圈，K表示触点。

Title; Size; Number; Revision; Date:; Sheet of; File:; C:\worktop\fjl_20191023\悬挂链_1.sch; Drawn By:; J1变频器启动继电器; L2报警指示灯; J2联动/手动控制; J3正/反转控制; L1运行指示; J5外部急停; SB3外部急停; L4外部急停指示灯; J6主动限位; J7从动限位; L5主动限位指示; L6从动限位指示灯; J8启动继电器; 触点举例：K2_1NO_1，K2表示继电器编号，1NO其中1表示第一组触点， NO表示常开，最后一个1表示触点1号端口 NC表示常闭; COM; VCI; GND; 停止 暂时停止; 变频器Z2; 变频器Z1; Z1_GND; 悬挂链_1
