microsysdeve/fjl_20191023/粉尘控制_1.pdf

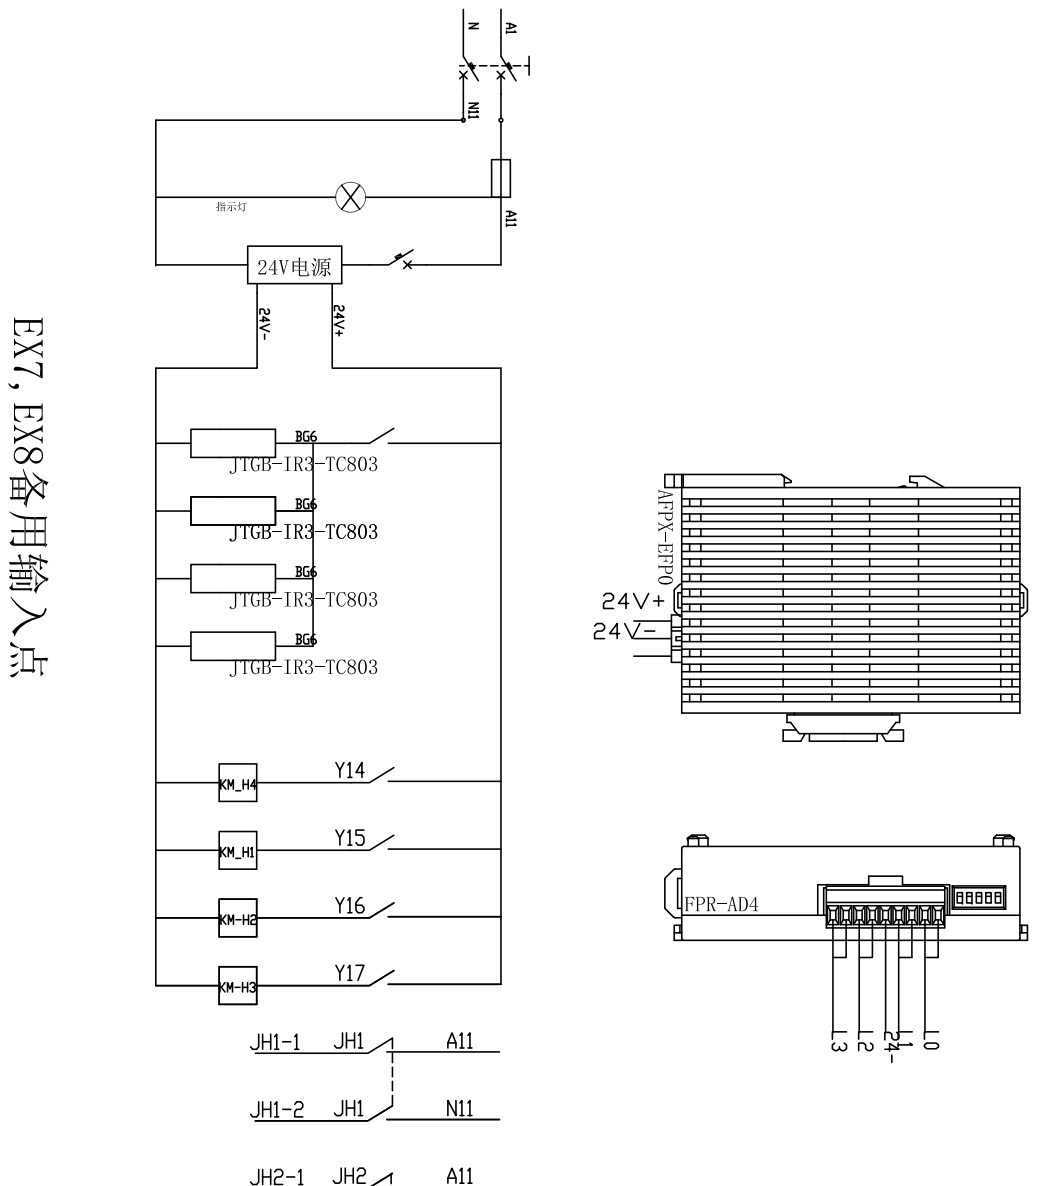
[picture p14: page 1]
