microsysdeve/fjl_20191023/粉尘控制_2.pdf

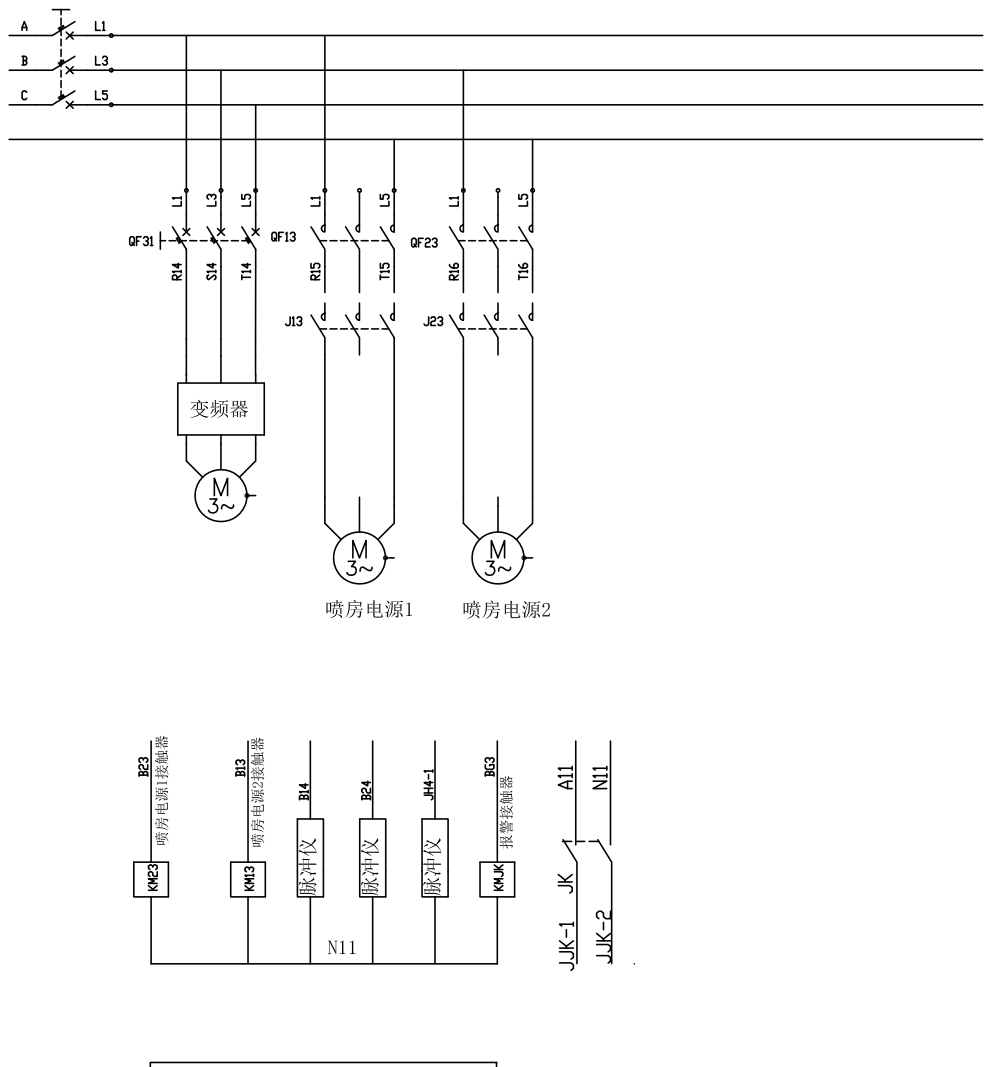
[picture p15: page 1]
