microsysdeve/fjl_20191023/粉尘控制_3.pdf

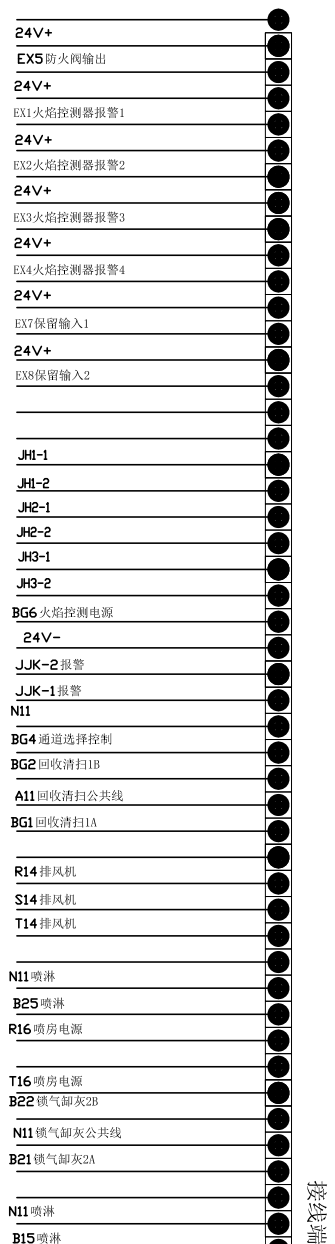
[picture p16: page 1]
