microsysdeve/fjl_20191023/(commit log)

2019-10-22 金工热能表控制由原来继电器改为比例输出
    [热风循环.Sch]
2019-11-13 添加文件
    [悬挂链.sch]
2019-12-01 中间更改
    [喷粉线控制柜面板.dwg, 粉尘控制.dwg]
2019-12-24 文件修改
2019-12-29 AD通道可行
2020-02-22 原立即数K20改为DT7928
2020-03-14 喷房电源可行
2020-03-14 除尘结束版本
2020-03-18 现场确认版本
2020-03-18 报警输出指向Y2
2020-03-18 R32受到R276控制
2020-05-09 烘道热能水循环水泵输出R102受到热风循环燃烧机启动按钮控制，并且启动后不停 添加Y14 R3a控制Y14
2021-03-01 现场二次回来递交
